nht-cyb/balancing-cube-pendulum/Reports/Slide_Nhom8_Final.pdf

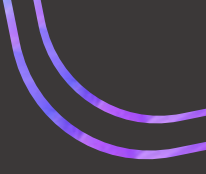
[picture p134: figure]
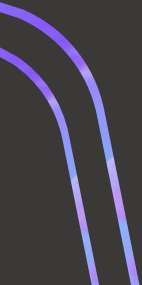
[picture p135: figure]
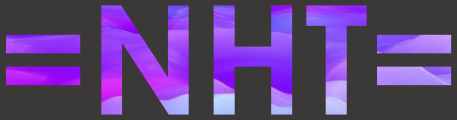
[picture p136: figure]
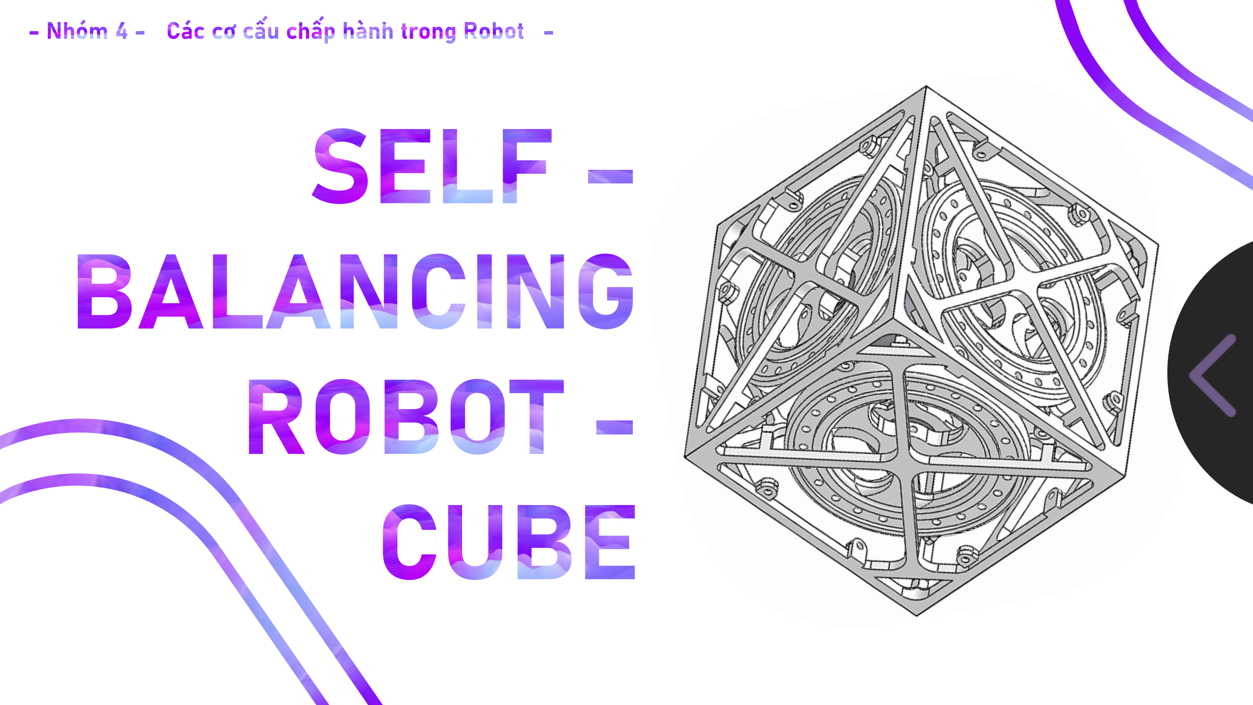
[picture p137: page 3]
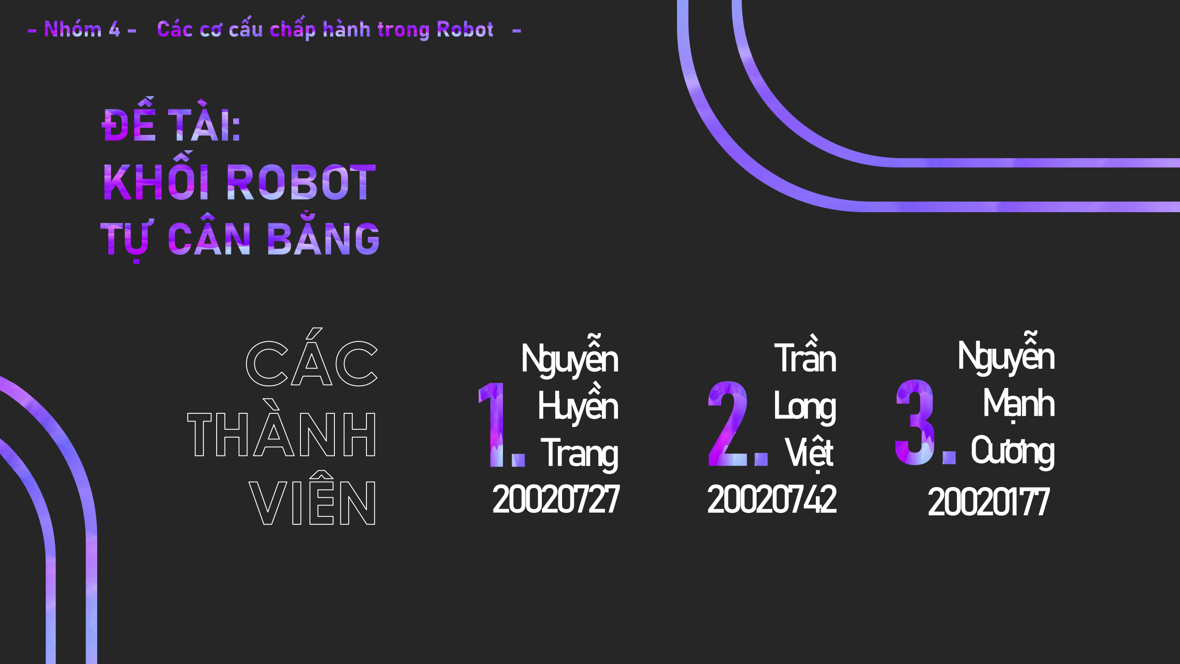
[picture p138: page 4]

## Nguyễn Huyền Trang

20020727

## Trần Long Việt

20020742

## Nguyễn Mạnh Cương

20020177

# ROBOT KHỐI

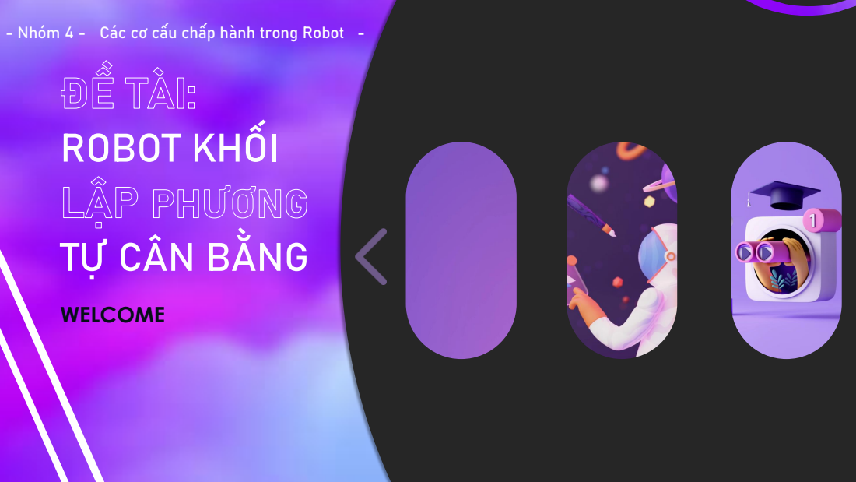
[picture p139: page 5]
WELCOME

- Nhóm 4 - Các cơ cấu chấp hành trong Robot -

TỰ CÂN BẰNG

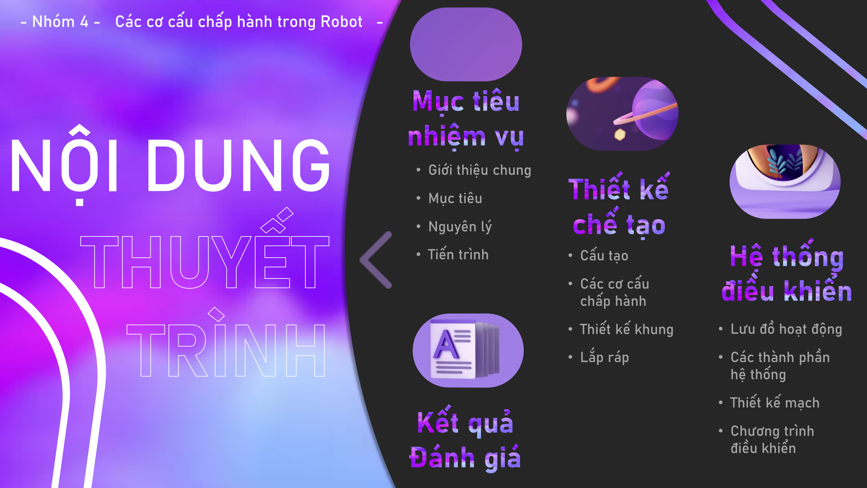
[picture p140: page 6]

# NỘI DUNG

- Nhóm 4 - Các cơ cấu chấp hành trong Robot -
- Giới thiệu chung
- Mục tiêu
- Nguyên lý
- Tiến trình
- Lưu đồ hoạt động
- Các thành phần
hệ thống
- Thiết kế mạch
- Chương trình
điều khiển
- Cấu tạo
- Các cơ cấu
chấp hành
- Thiết kế khung
- Lắp ráp

# MỤC TIÊU

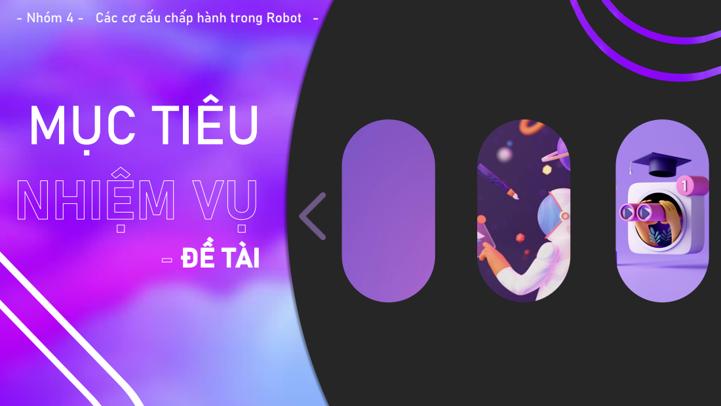
[picture p141: page 7]

- Nhóm 4 - Các cơ cấu chấp hành trong Robot -

# GIỚI

## - Lấy ý tưởng từ Cubli - được tạo ra lần đầu tiên

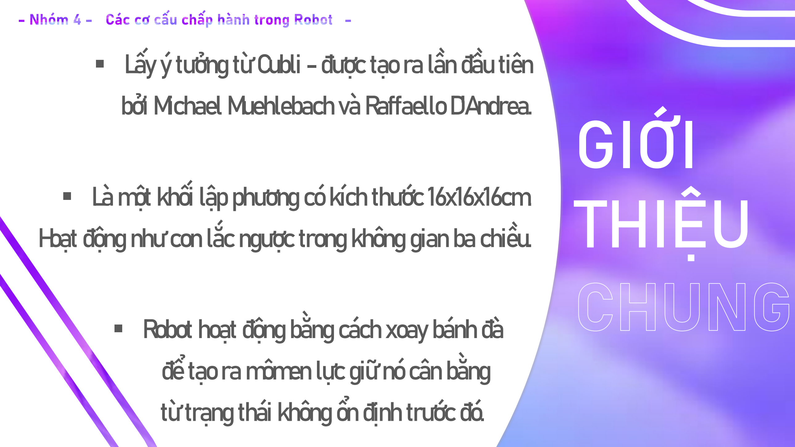
[picture p142: page 8]

# THIỆU

bởi Michael Muehlebach và Raffaello D’Andrea.

- Là một khối lập phương có kích thước 16x16x16cm. Hoạt động như con lắc ngược trong không gian ba chiều.

## - Robot hoạt động bằng cách xoay bánh đà để tạo ra mômen lực giữ nó cân bằng

từ trạng thái không ổn định trước đó.

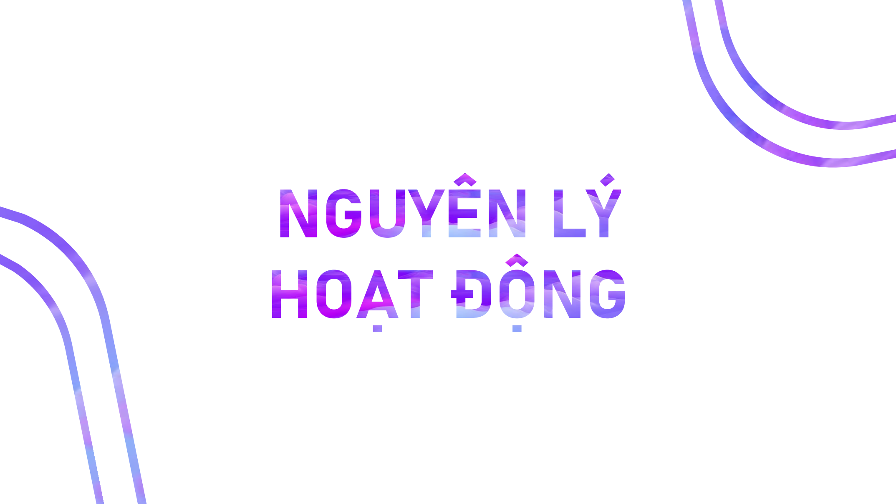
[picture p143: page 9]

## - Dựa trên tác dụng của lực quán tính và nguyên lý

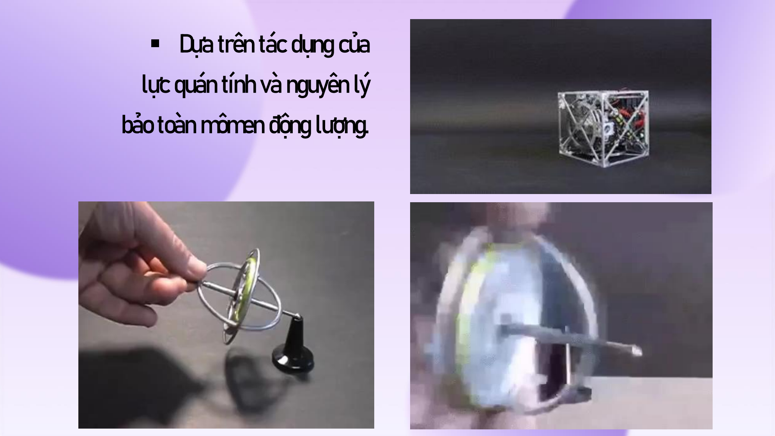
[picture p144: page 10]

bảo toàn mômen động lượng.

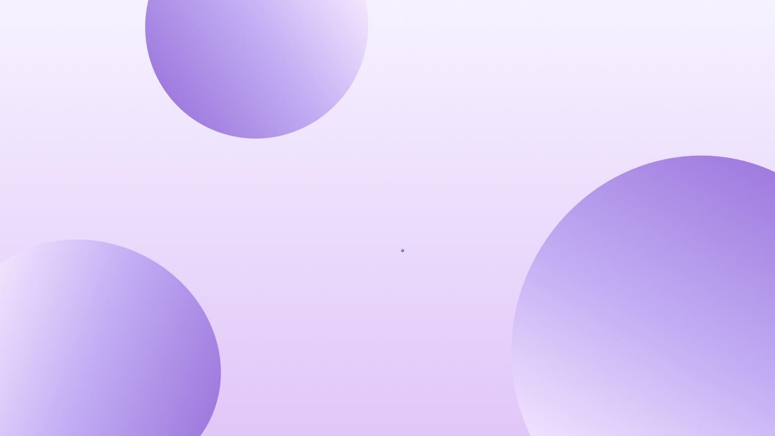
[picture p145: page 11]

# 2. Run

# 1. Records

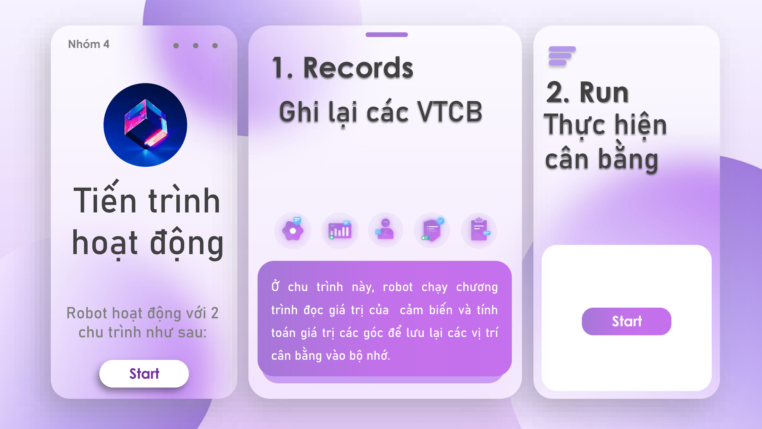
[picture p146: page 12]

Ở chu trình này, robot chạy chương

trình đọc giá trị của cảm biến và

tính toán giá trị các góc để lưu lại các vị trí cân bằng vào bộ nhớ.

# Tiến trình hoạt động

Start

Robot hoạt động với 2
chu trình như sau:
Nhóm 4 | . . .

Start

# Ghi lại các VTCB Thực hiện cân bằng

Ở chu trình này, robot chạy chương

trình đọc giá trị của cảm biến và tính

toán giá trị các góc để lưu lại các vị trí cân bằng vào bộ nhớ.

1.

# Records

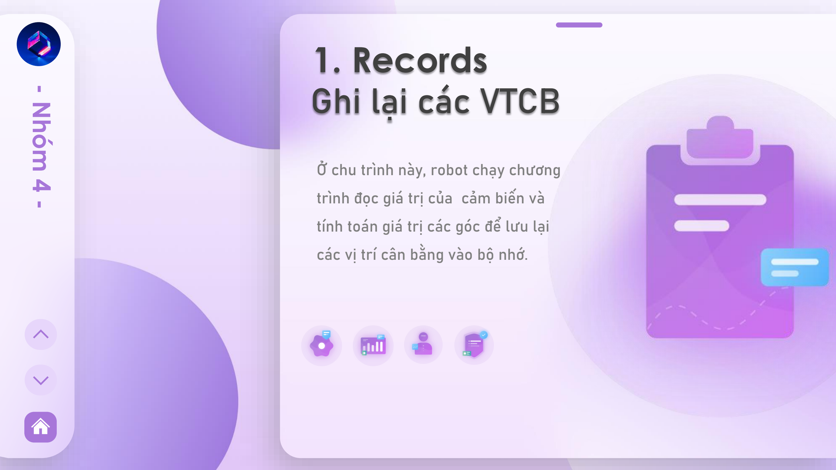
[picture p147: page 13]

Ở chu trình này, robot chạy chương

trình đọc giá trị của cảm biến và

tính toán giá trị các góc để lưu lại các vị trí cân bằng vào bộ nhớ.

# Ghi lại các VTCB

## - Nhóm 4 -

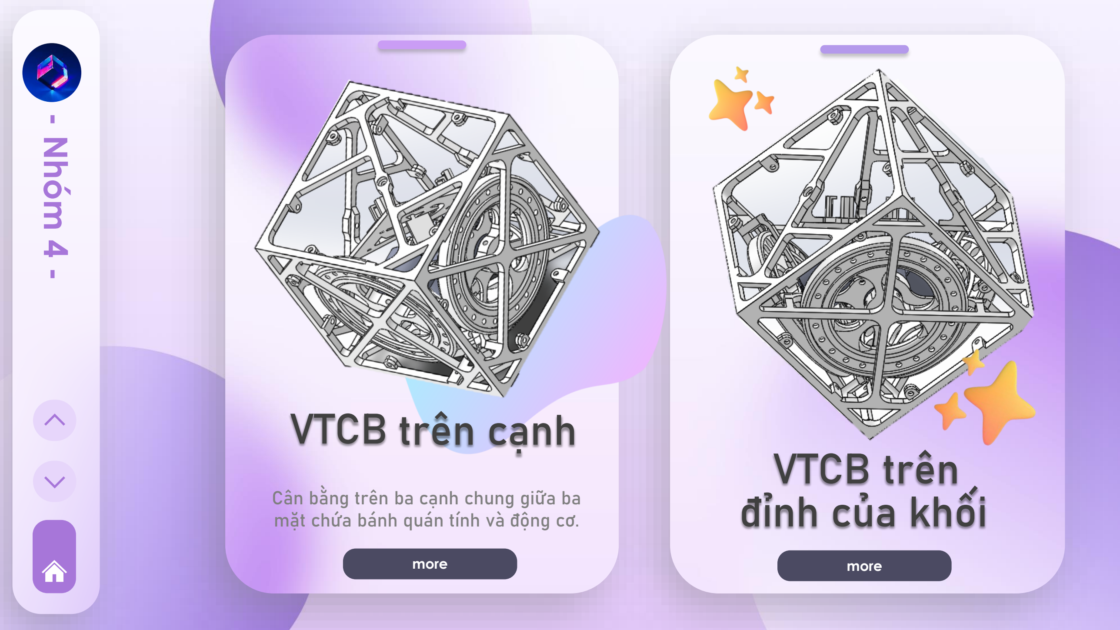
[picture p148: page 14]

# VTCB trên

đỉnh của khối Cân bằng trên ba cạnh chung giữa ba mặt chứa bánh quán tính và động cơ.

more

# VTCB

more

## - Nhóm 4

# trên cạnh

# 2. Run

# Thực hiện

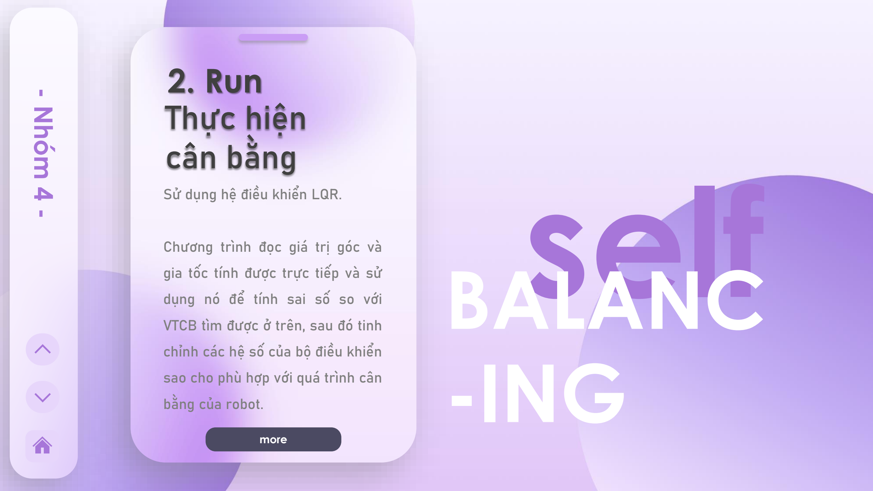
[picture p149: page 15]

more

# self BALANC -ING

## - Nhóm 4 -

# cân bằng

Sử dụng hệ điều khiển LQR

Chương trình đọc giá trị góc và gia tốc tính được trực tiếp và sử

dụng nó để tính sai số so với

VTCB tìm được

ở trên, sau đó tinh
chỉnh các hệ số của bộ điều khiển

sao cho phù hợp với quá trình cân bằng của robot

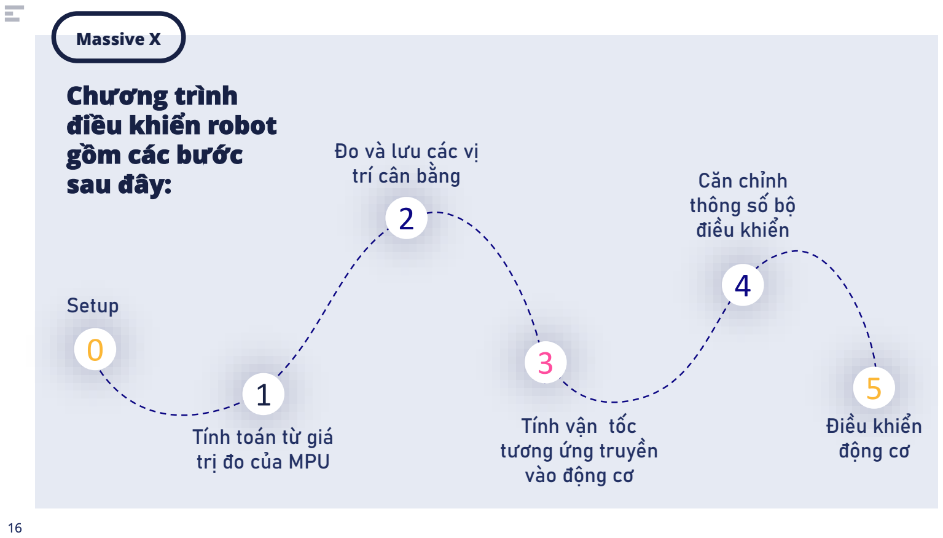
[picture p150: page 16]

16

Massive X

0

Setup

Đo và lưu các vị
trí cân bằng
2

Tính toán từ giá
trị đo của MPU

1
Tính vận tốc
tương ứng truyền
vào động cơ

### Chương trình

### điều khiển robot

### gồm các bước sau đây:

3

4

Căn chỉnh
thông số bộ
điều khiển

5

Điều khiển
động cơ

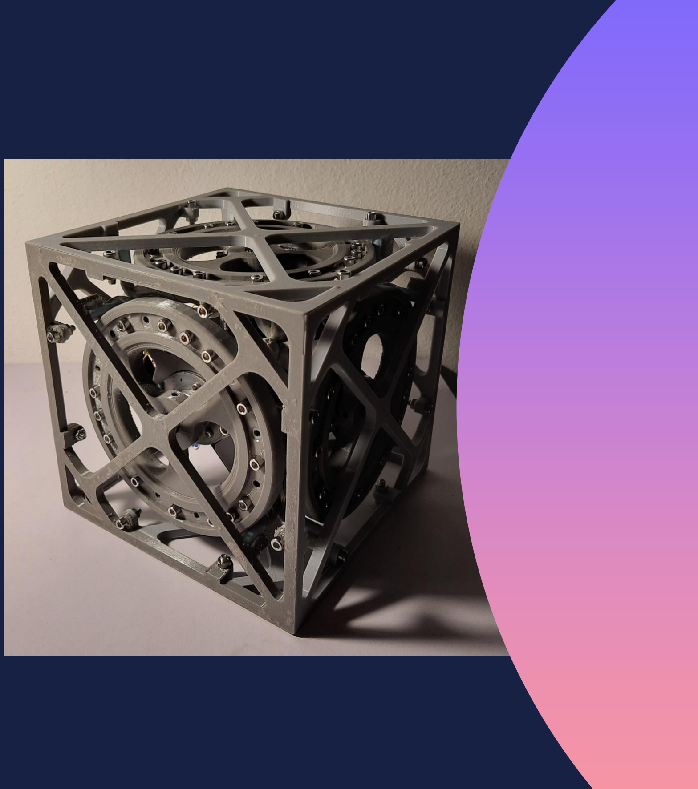
[picture p151: figure]

Massive X presentation to DesignBall team

Massive X

bCc (https://www.facebook.com/)

### Khung robot

01

Được in 3D, chất liệu nhựa PLA

### Mạch điều khiển

02

Sử dụng bộ điều khiển ESP32

### Cơ cấu chấp hành

03

Gồm Cảm biển gia tốc MPU6050 và dộng cơ BLDC Nidec

# Cấu tạo robot

Donec eget viverra nisi, non luctus arcu. Sed ipsum leo, volutpat id convallis vitae, mollis ac dui. Cum sociis natoque penatibus et magnis dis parturient montes, nascetur ridiculus mus. Nulla luctus dapibus metus nec mollis. Etiam lacus nulla, bibendum egestas suscipit ut, sollicitudin eu massa. Phasellus semper quam justo, vel aliquam magna lobortis at.

# Cấu tạo

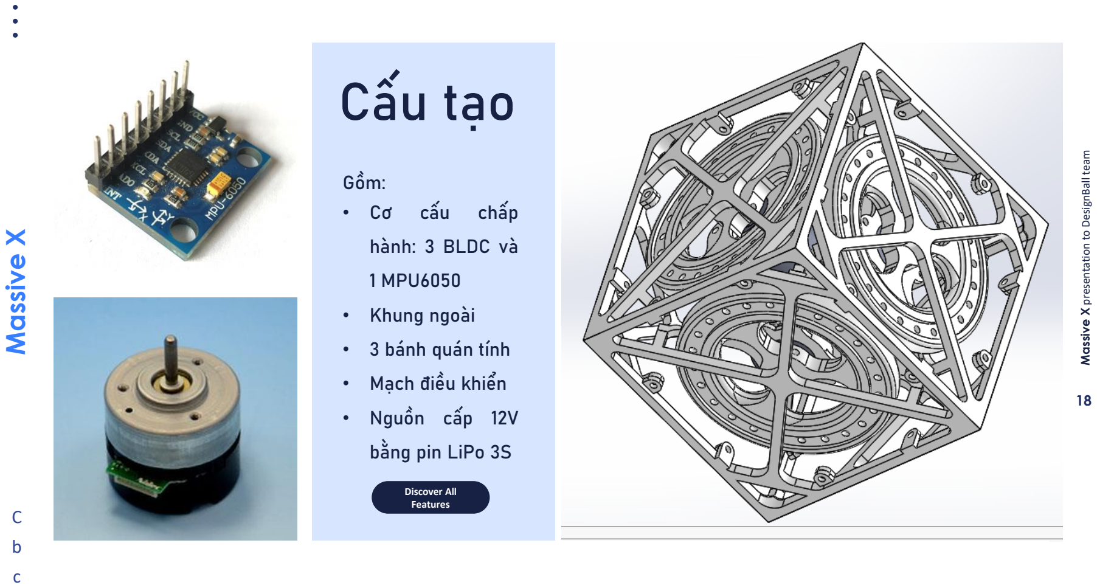
[picture p152: page 18]

Massive X presentation to DesignBall team

Massive X

18

bCc (https://www.facebook.com/)

Gồm: • Cơ | cấu | chấp

hành
:

3 BLDC và

1 MPU6050

- Khung ngoài • 3 bánh quán tính • Mạch điều khiển • Nguồn cấp 12V

bằng pin LiPo
3

S

Discover All
Features

# Khung robot

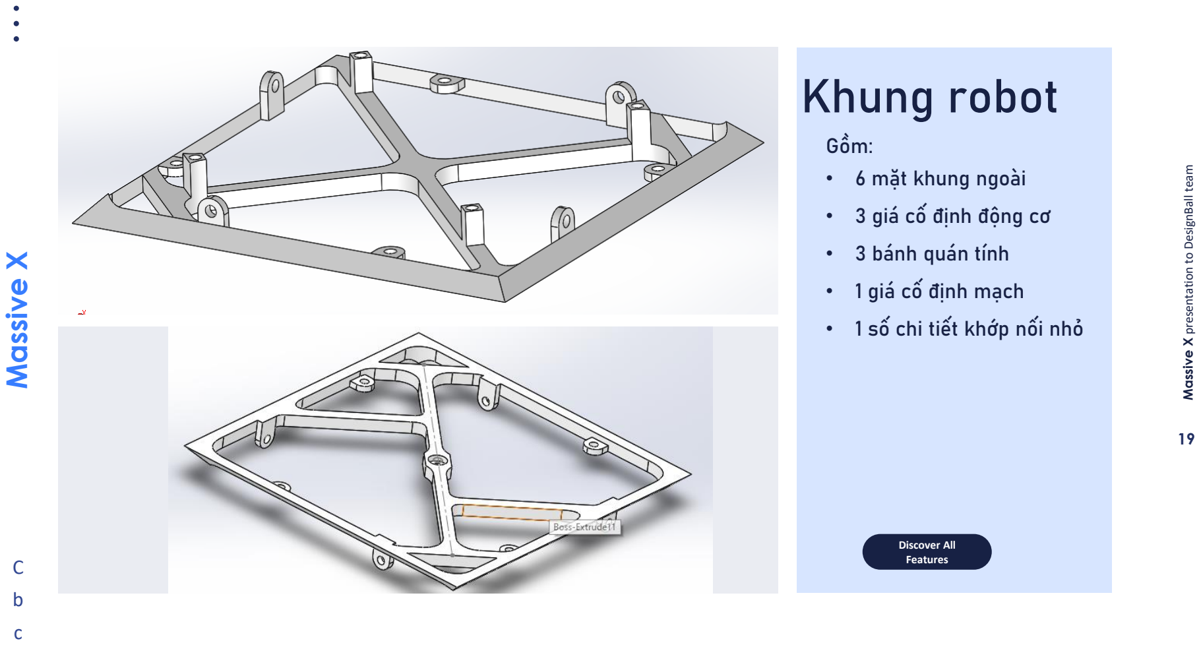
[picture p153: page 19]

Massive X presentation to DesignBall team

Massive X

19

bCc (https://www.facebook.com/)

Discover All
Features

Gồm: • 6 mặt khung ngoài • 3 giá cố định động cơ • 3 bánh quán tính • 1 giá cố định mạch • 1 số chi tiết khớp nối nhỏ

# Khung robot

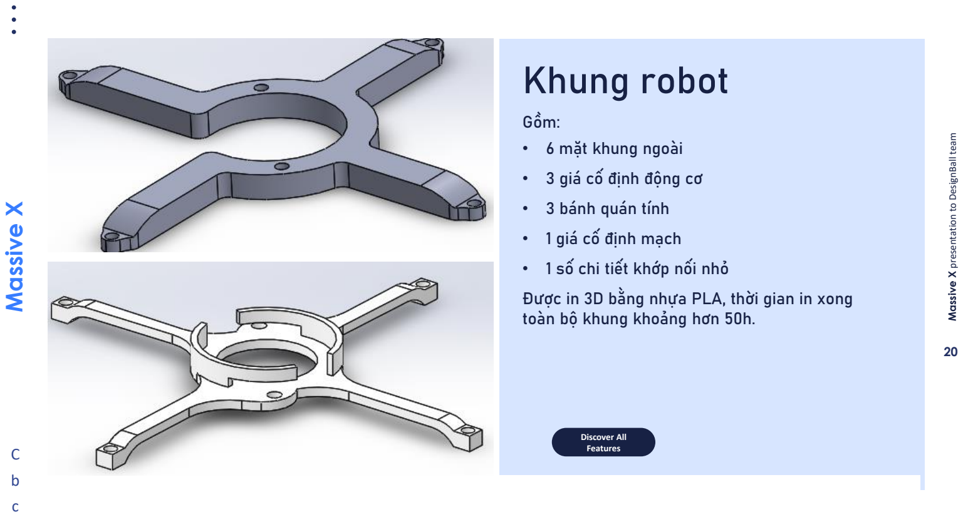
[picture p154: page 20]

Massive X presentation to DesignBall team

Massive X

20

bCc (https://www.facebook.com/)

Gồm: • 6 mặt khung ngoài • 3 giá cố định động cơ • 3 bánh quán tính • 1 giá cố định mạch • 1 số chi tiết khớp nối nhỏ

Discover All
Features

Được in 3D bằng nhựa PLA, thời gian in xong toàn bộ khung khoảng hơn 50h.

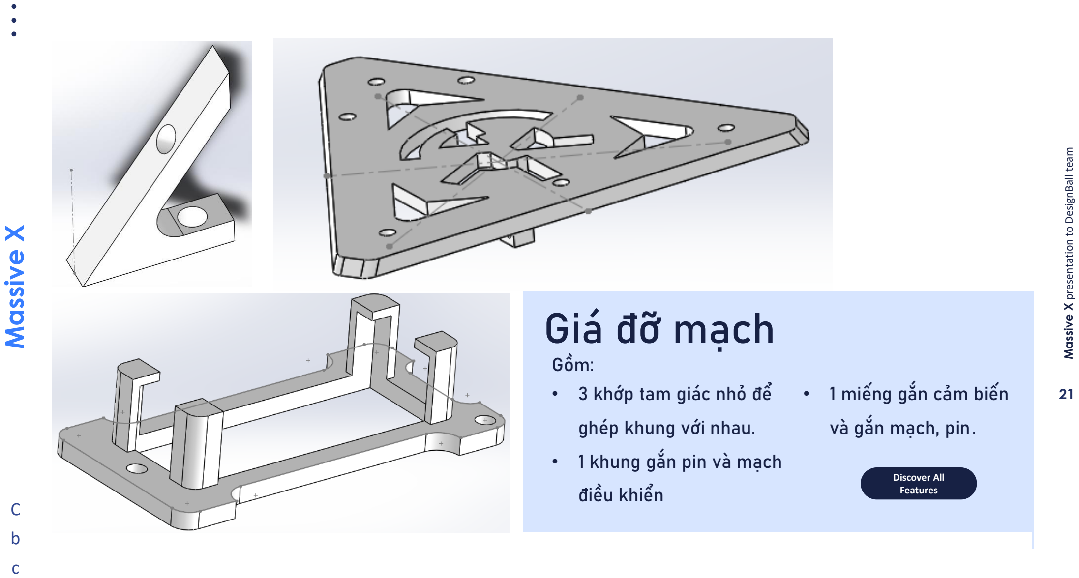
[picture p155: page 21]

Massive X presentation to DesignBall team

Massive X

21

bCc (https://www.facebook.com/)

Gồm: • 3 khớp tam giác nhỏ để

ghép khung với nhau.
- 1 khung gắn pin và mạch

điều khiển

Discover All
Features

# Giá đỡ mạch

- 1 miếng gắn cảm biến

và gắn mạch, pin

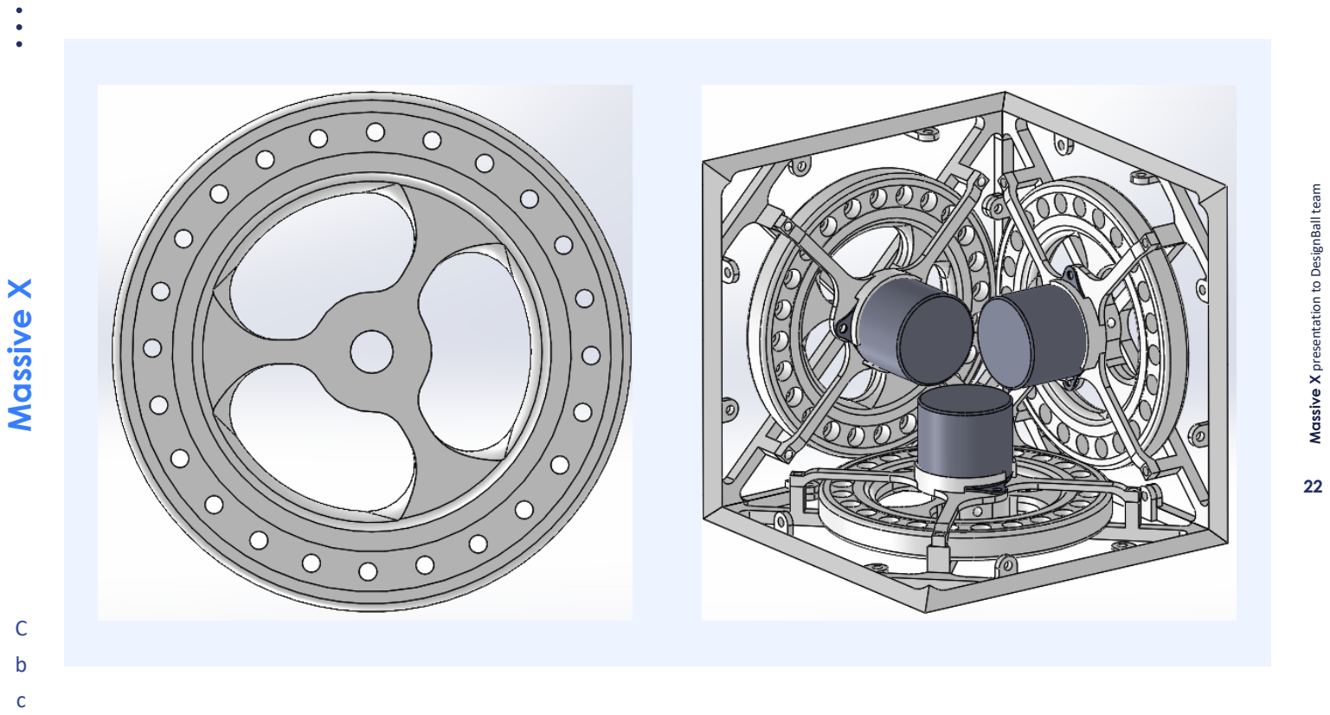
[picture p156: page 22]

Massive X presentation to DesignBall team

Massive X

22

bCc (https://www.facebook.com/)

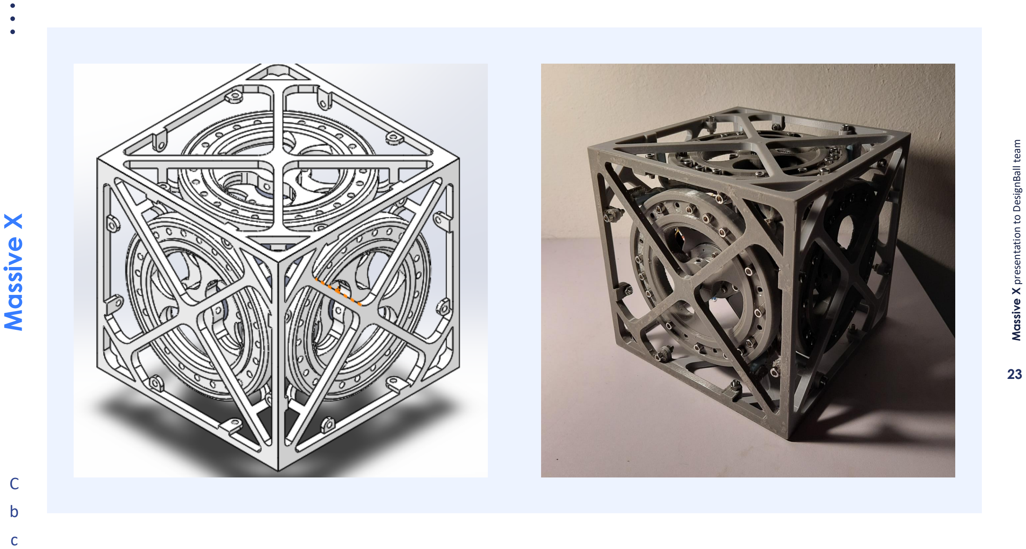
[picture p157: page 23]

Massive X presentation to DesignBall team

Massive X

23

bCc (https://www.facebook.com/)

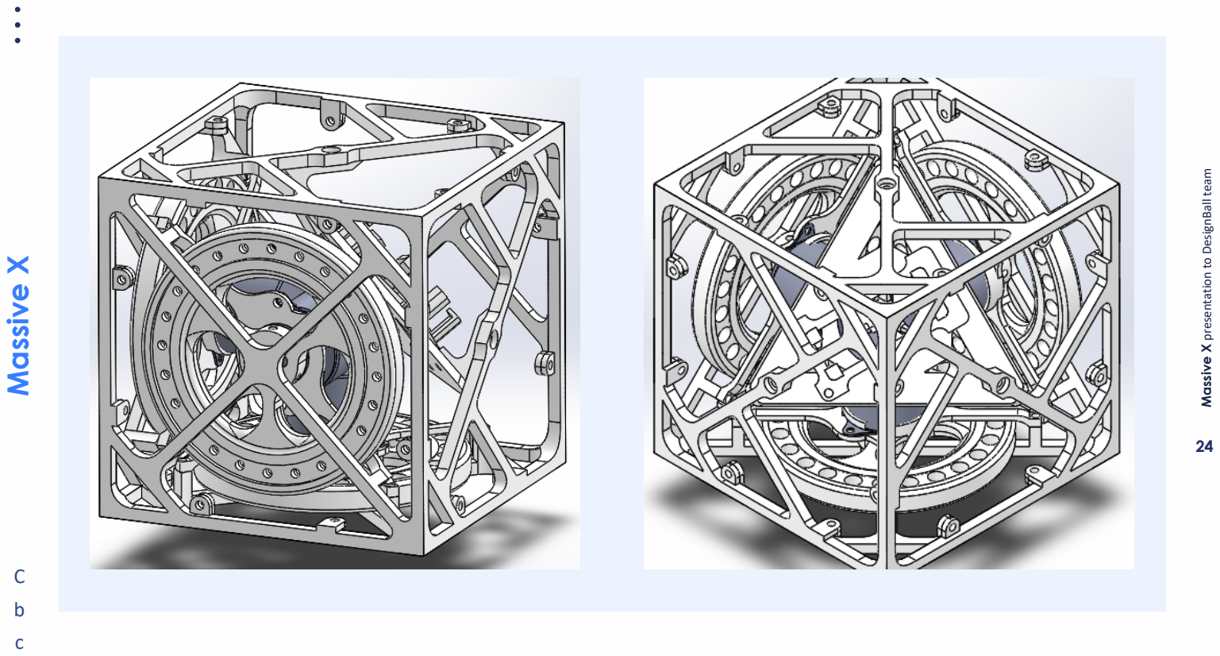
[picture p158: page 24]

Massive X presentation to DesignBall team

Massive X

24

bCc (https://www.facebook.com/)

Massive X presentation to DesignBall team

Massive X

25

b (https://www.facebook.com/)

C (https://www.linkedin.com/)

c (https://twitter.com/)

# Các vấn đề nảy sinh

- Kích thước vẽ và kích thước in có sự chênh lệch. Quá trình thiết kế phần cứng khi vẽ

3D trên Solidworks còn chưa có kinh nghiệm và chưa được kiểm tra kỹ lưỡng dẫn

đến một số kích thước sai. Các mối nối không khớp, không lắp vào nhau được.

- Bánh chạm vào nhau khi quay; trục bánh bé, không vừa trục động cơ.
- Trục giữ động cơ yếu, không thể chịu được khối lượng động cơ và bánh; chiều cao của

trục quá lớn nên khi ghép các mặt bị chạm nhau.

- Quá trình hàn mạch còn hàn sai, hỏng bảng mạch, phải hàn lại nhiều lần.
- Giải quyết: đo, cắt gọt, mài thủ công để các chi tiết vừa khớp.

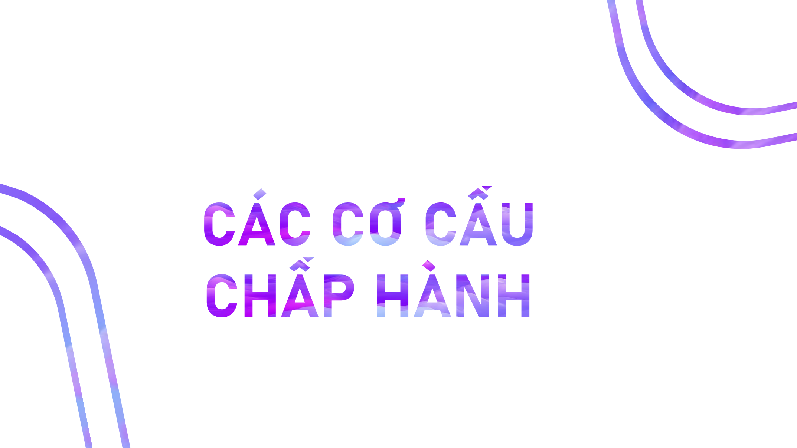
[picture p159: page 26]

Massive X presentation to DesignBall team

Massive X

26

bCc (https://www.facebook.com/)

# Động cơ BLDC Nidec 24H

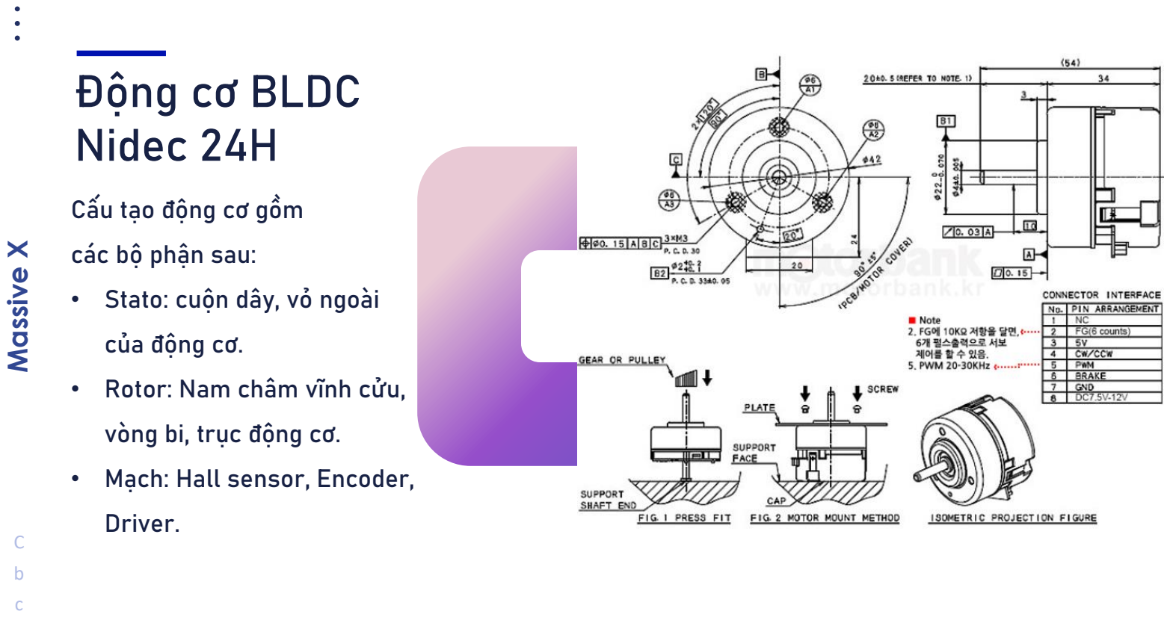
[picture p160: page 27]

Massive X presentation to DesignBall team

Massive X

27

bCc (https://www.facebook.com/)

Cấu tạo động cơ gồm

các bộ phận sau: • Stato: cuộn dây, vỏ ngoài

của động cơ.

- Rotor: Nam châm vĩnh cửu,

vòng bi, trục động cơ.

- Mạch: Hall sensor, Encoder,

Driver.

Massive X presentation to DesignBall team

Massive X

28

b (https://www.facebook.com/)

C (https://www.linkedin.com/)

c (https://twitter.com/)

# Động cơ BLDC

- Stator: được cấu tạo từ các lá thép kỹ thuật điện với các cuộn dây được đặt trong các khe cắt xung quanh chu vi phía trong của stator.
- Rotor được cấu tạo gồm nam châm vĩnh cửu, có nhiệm vụ kích từ. Rotor: được gắn

vào trục động cơ và trên bề mặt rotor có dán các thanh nam châm vĩnh cửu.
- Rotor được gắn với trục xoay của động cơ, trục chính phía trước gắn với tải, trục phụ

phía sau gắn với cảm biến Hall và encoder quang học.

- Khi dòng điện chạy qua một trong ba cuộn dây stator sẽ tạo ra cực từ hút những nam châm vĩnh cửu gần nhất có cực từ trái dấu. Cấp điện tuần tự cho mỗi cuộn dây sẽ làm

cho rotor quay theo từ trường quay. Rotor sẽ tiếp tục chuyển động nếu dòng điện dịch

chuyển sang một cuộn dây liền kề.

Massive X presentation to DesignBall team

Massive X

29

bCc (https://www.facebook.com/)

Giá trị | Điều kiện hoạt động | Min.

Thông

thường

Max. Đơn vị

Điện thế hoạt động

Loại động cơ 12

V | 8.0 | 12 | 15

V

Loại động cơ 24

V | 21.6 | 24 | 26.4

V

Dòng điện hoạt động | Vận hành liên tục
- | 0.75 | 0.9

A
Lực xoay mômen xoắn | Vận hành liên tục
- | 20 | 50 | mN.m
Output power | Vận hành liên tục

5

7 | 9.0

W

Tốc độ không tải

3500 | 4300 | 4900
rpm
- 5900

Quán tính của rotor | Giá trị được tính toán
- 14.0
Hằng số cơ học | Giá trị được tính toán
- 2.1
- msec
Hằng số điện | Giá trị được tính toán
- 1.2
- msec

Áp suất âm

Không tải, đến
, đo cách động cơ

30cm

- | 50 | dB(A)

Nhiệt độ làm việc

Độ ẩm từ
5

% đến 90
%

, không bão

hòa

10

- 50
Khối lượng động cơ | Không
- 110

g
Tuổi thọ | 5000

h

Massive X presentation to DesignBall team

Massive X

30

b (https://www.facebook.com/)

C (https://www.linkedin.com/)

c (https://twitter.com/)

STT | Tên gọi | Chức năng
1 | CHA | Dùng encoder: Kênh A đầu ra của encoder; kiểm tra pha, xung trên một vòng quay;
| | điện áp: HIGH = 5V, LOW = 0V.
2 | CHB | Dùng encoder: Kênh B đầu ra của encoder; kiểm tra pha , 100 xung trên một vòng
| | quay; điện áp: HIGH = 5V, LOW = 0V.
| FG | Chế độ cơ bản: open-drain tachometer: thiết bị đo tốc độ góc cấu hình chân open-
| | drain, khi sử dụng cần nối thêm trở ngoài vào mạch, đo 6 xung trên 1 vòng xoay, .
3 | Vin | Cổng logic. Cấp nguồn từ 3.3V – 5.5V cho encoder
4 | DIR | Dây tín hiệu đảo chiều xoay của động cơ. đến , hoặc cổng tín hiệu mở OPEN thì động
| | cơ xoay theo chiều kin đồng hồ; thì động cơ xoay ngược chiều kim đồng hồ.
5 | PWM | Truyền tín hiệu xung điều khiển tốc độ quay của động cơ.
6 | EN/BRAKE | Dây phanh để nối ngắn nguồn dừng khẩn cấp động cơ.
7 | GND | Dây đất, cấp nguồn điện tích âm cho động cơ.
8 | VCC | Cấp nguồn điện dương cho động cơ, dòng DC .

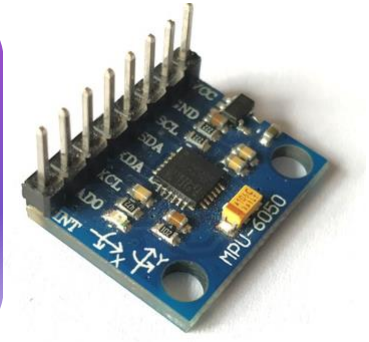
[picture p161: figure]

Massive X presentation to DesignBall team

Massive X

31

bCc (https://www.facebook.com/)

# Cảm biến gia tốc góc MPU6050

MPU6050 là một Hệ thống động cơ điện vi

mô: bao gồm gia tốc kế ba trục và con quay

hồi chuyển ba trục. • Để đo góc và xác định vị trí của robot

trong không gian theo các chiều X, Y, Z.

- Xác định vị trí, vận tốc, gia tốc của robot.

Massive X presentation to DesignBall team

Massive X

32

b (https://www.facebook.com/)

C (https://www.linkedin.com/)

c (https://twitter.com/)

# Cảm biến gia tốc góc MPU6050

- MPU6050 có một gia tốc kế trên chip có thể đo gia tốc trên bốn dải thang đo đầy đủ có

thể lập trình là ±2g, ±4g, ±8g và ±16g.

- MPU6050 có một con quay hồi chuyển trên chip có thể đo góc quay trên bốn phạm vi tỷ lệ

đầy đủ có thể lập trình là ±250°/s, ±500°/s, ±1000°/s và ±2000°/s.

- Bên trong cảm biến tích hợp 6 trục cảm biến bao gồm con quay hồi 3 chuyển trục X, Y, Z.

## Các thành phần hệ thống

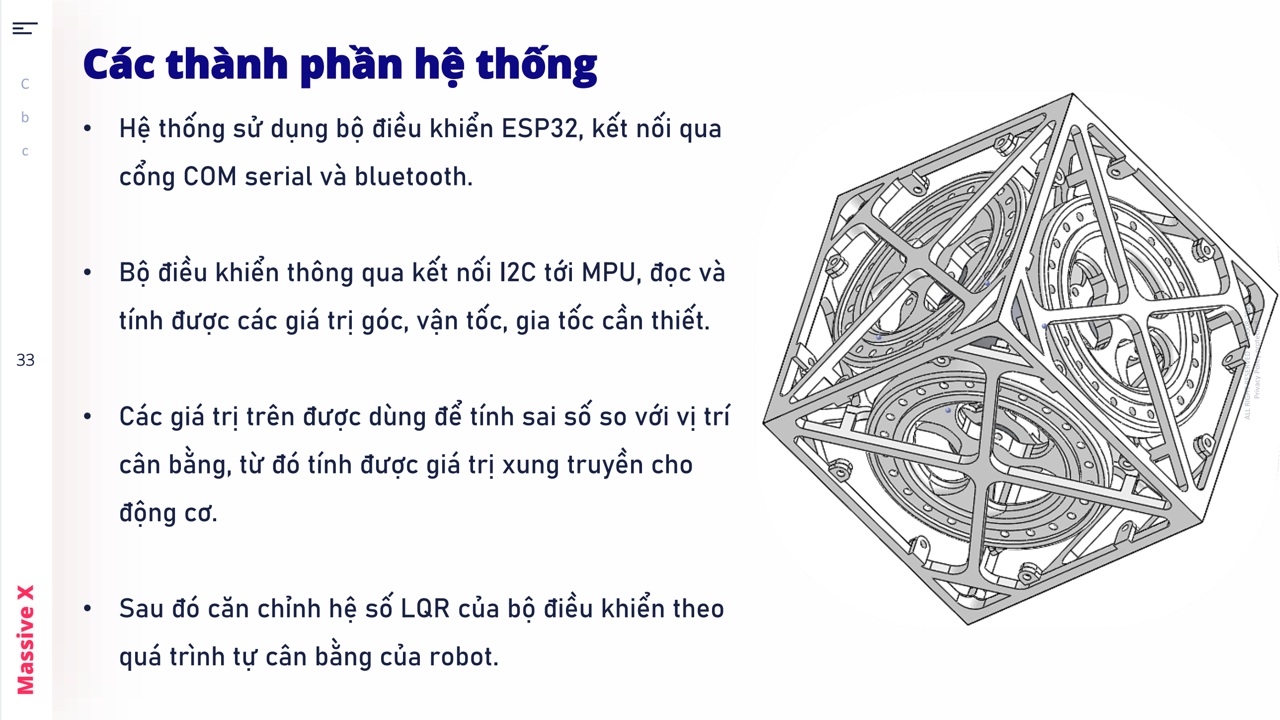
[picture p162: page 33]

Massive X

33

- Hệ thống sử dụng bộ điều khiển ESP32, kết nối qua

cổng COM serial và bluetooth.

- Bộ điều khiển thông qua kết nối I2C tới MPU, đọc và

tính được các giá trị góc, vận tốc, gia tốc cần thiết.

- Các giá trị trên được dùng để tính sai số so với vị trí cân bằng, từ đó tính được giá trị xung truyền cho

động cơ.

- Sau đó căn chỉnh hệ số LQR của bộ điều khiển theo quá trình tự cân bằng của robot.

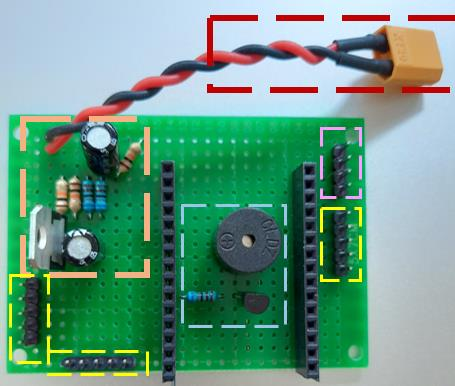
[picture p163: figure]

Massive X presentation to DesignBall team

Massive X

34

b (https://www.facebook.com/)

C (https://www.linkedin.com/)

c (https://twitter.com/)

# Mạch điều khiển gồm:

- 1 khối đỏ cấp nguồn chính 12V cho 3 động cơ.
- 1 khối cam lấy nguồn 12V hạ áp xuống 5V để cấp

cho ESP32 và MPU6050

- 3 khối vàng gồm 5 chân pin cắm 3 động cơ BLDC
- 1 khối hồng gồm 4 chân pin cắm 1 cảm biến

MPU6050

- 1 khối xanh gồm mạch còi chíp và đèn led bảo

hiệu chương trình.

- 2 hàng jump 15 chân cắm mạch điều khiển

ESP32

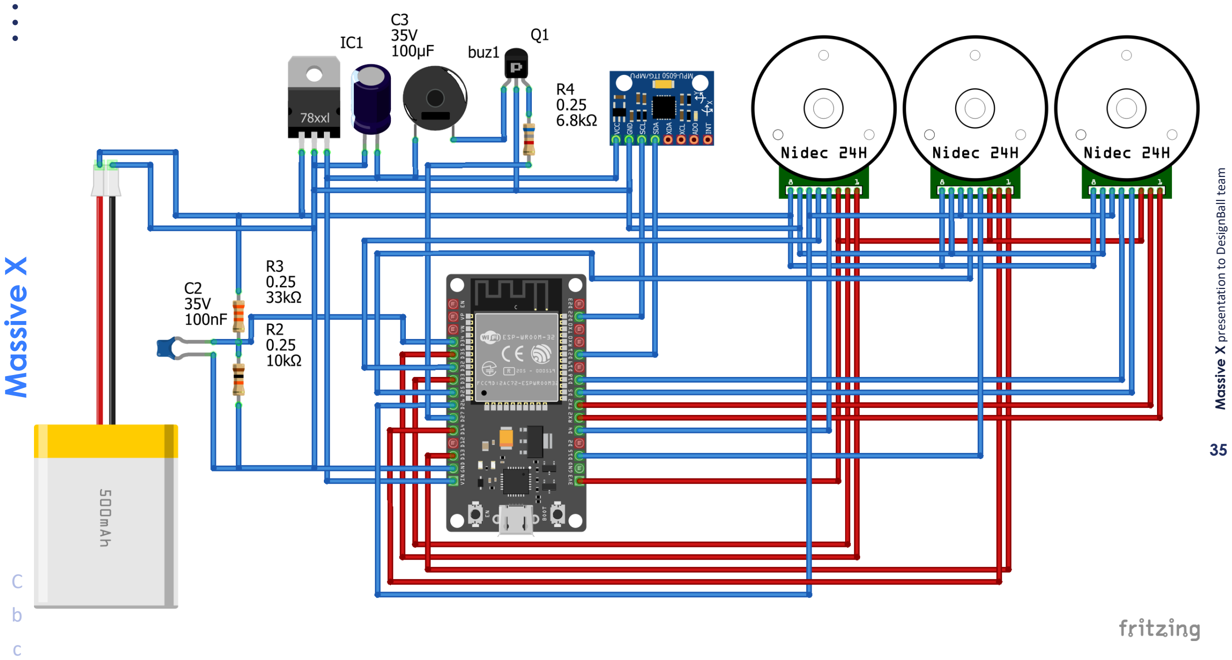
[picture p164: page 35]

Massive X presentation to DesignBall team

Massive X

35

bCc (https://www.facebook.com/)

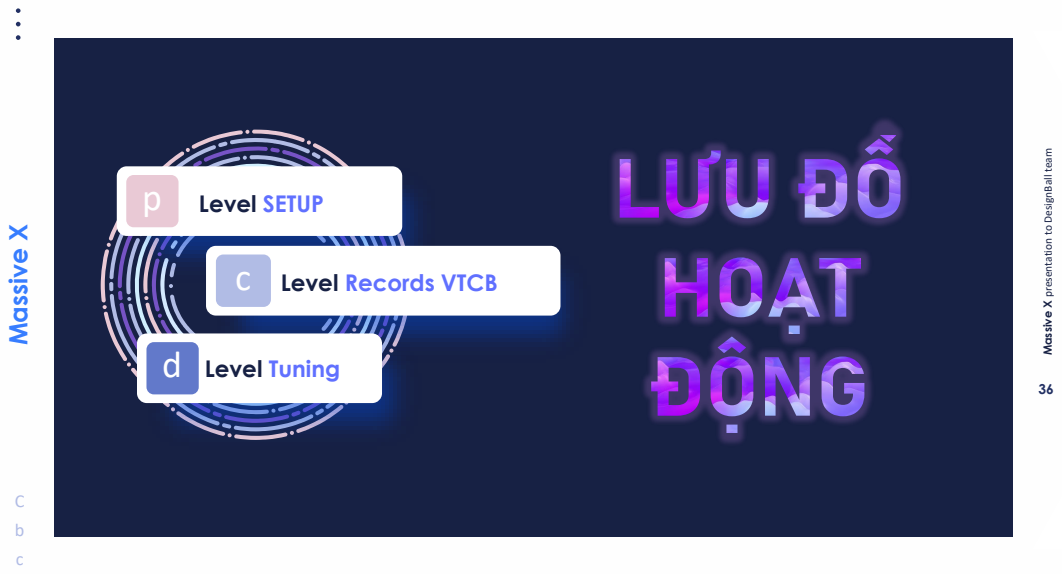
[picture p165: page 36]
Massive X; bCc; Level SETUP; Level Records VTCB; Level Tuning

Massive X presentation to DesignBall team

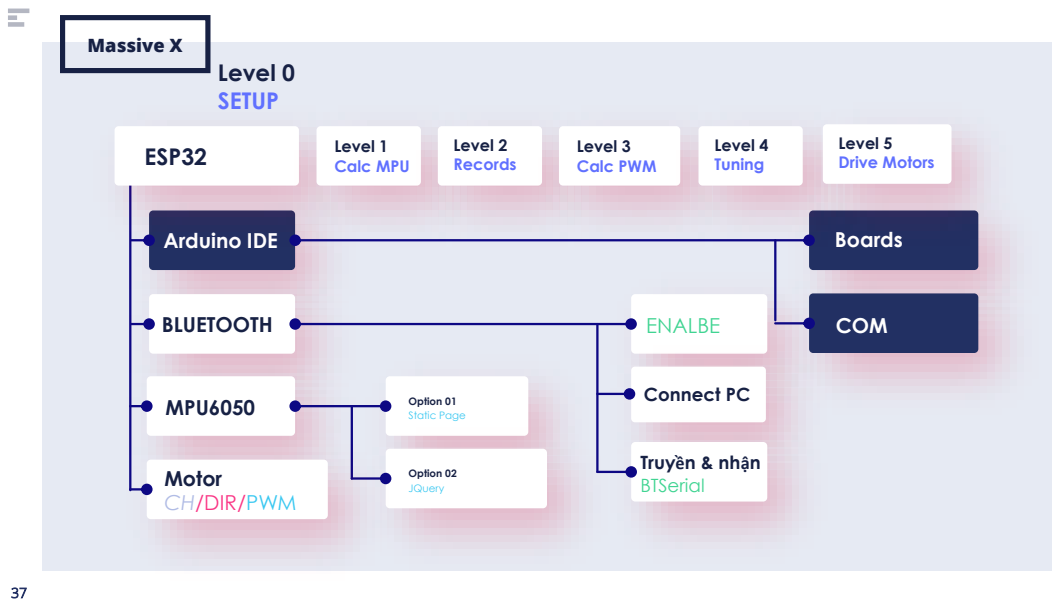
[picture p166: page 37]
Massive X; Option 01; Static Page; Option 02; JQuery; ENALBE; Connect PC; Arduino IDE; Boards; ESP32; BLUETOOTH; MPU6050; Level 0 SETUP; COM; Truyền & nhận BTSerial; Level 1 Calc MPU; Level 2 Records; Level 3 Calc PWM; Level 4 Tuning; Level 5 Drive Motors

Motor
CH/DIR/PWM

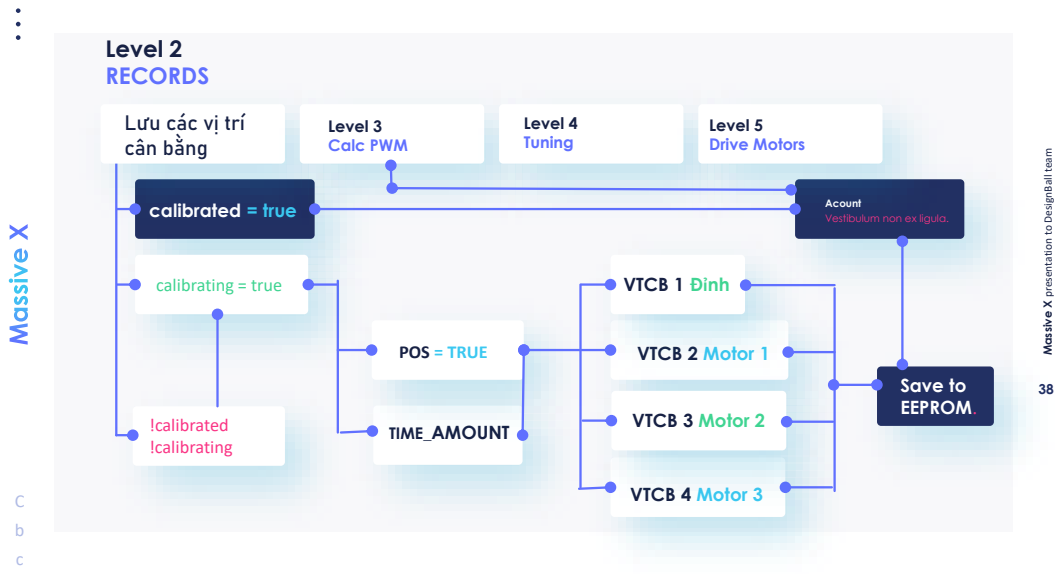
[picture p167: page 38]
VTCB 2 Motor 1; TIME_AMOUNT; VTCB 1 Đỉnh; VTCB 4 Motor 3; Acount calibrated = true; Vestibulum non ex ligula.; calibrating = true; POS = TRUE; Level 2 RECORDS; !calibrated !calibrating; Save to EEPROM.; VTCB 3 Motor 2; Level 3 Calc PWM; Level 4 Tuning; Level 5 Drive Motors

Lưu các vị trí
cân bằng

Massive X presentation to DesignBall team

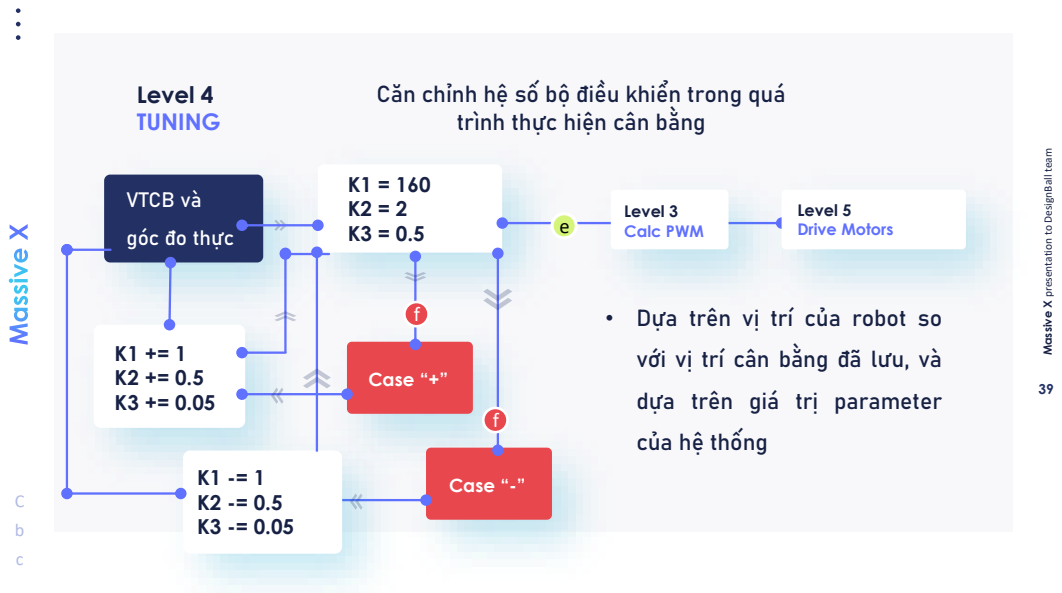
[picture p168: page 39]
bCc; Case “+” f; Level; 4 TUNING; Case “; 3 Calc PWM; 5 Drive Motors

Căn chỉnh hệ số bộ điều khiển trong quá

trình thực hiện cân bằng

Massive X presentation to DesignBall team

VTCB và
góc đo thực

• Dựa trên vị trí của robot so
với vị trí cân bằng đã lưu, và

dựa trên giá trị parameter
của hệ thống

U

s

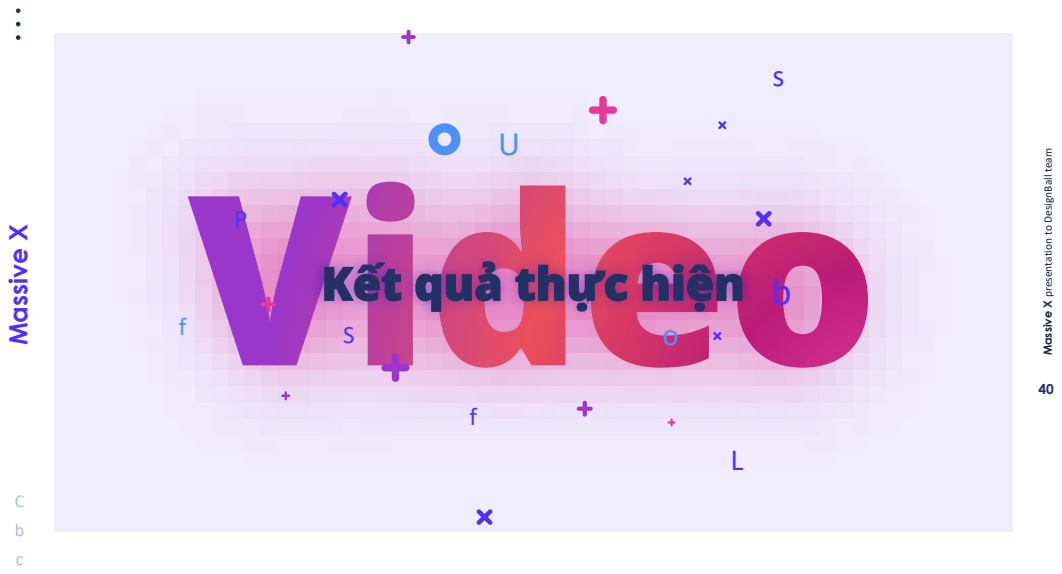
[picture p169: page 40]
Massive X; bCc

Massive X presentation to DesignBall team

Kết quả thực hiện o

U

s

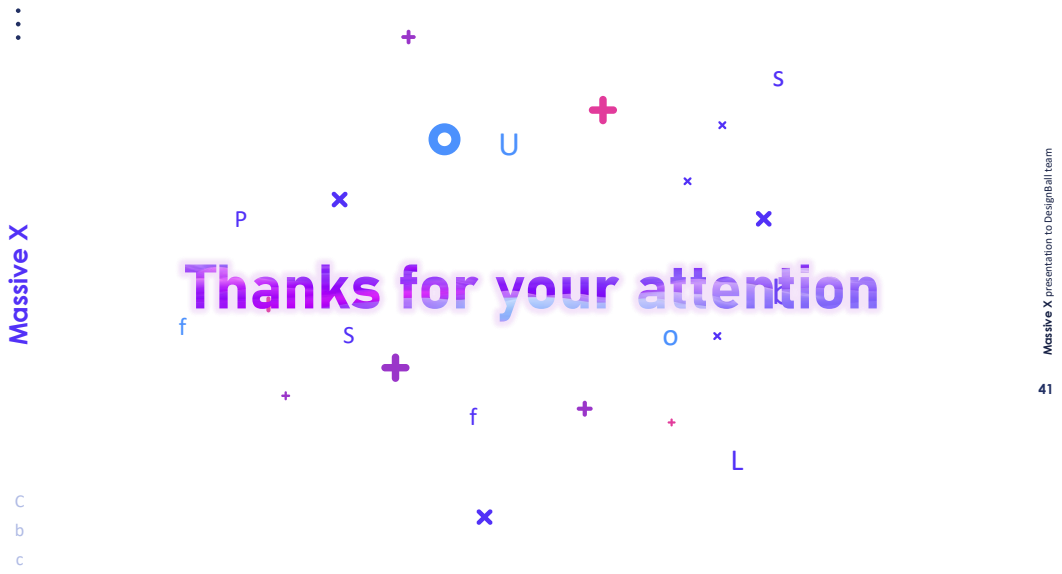
[picture p170: page 41]
Massive X; bCc

Massive X presentation to DesignBall team
