nht-cyb/balancing-cube-pendulum/model/20221113_214621.jpg

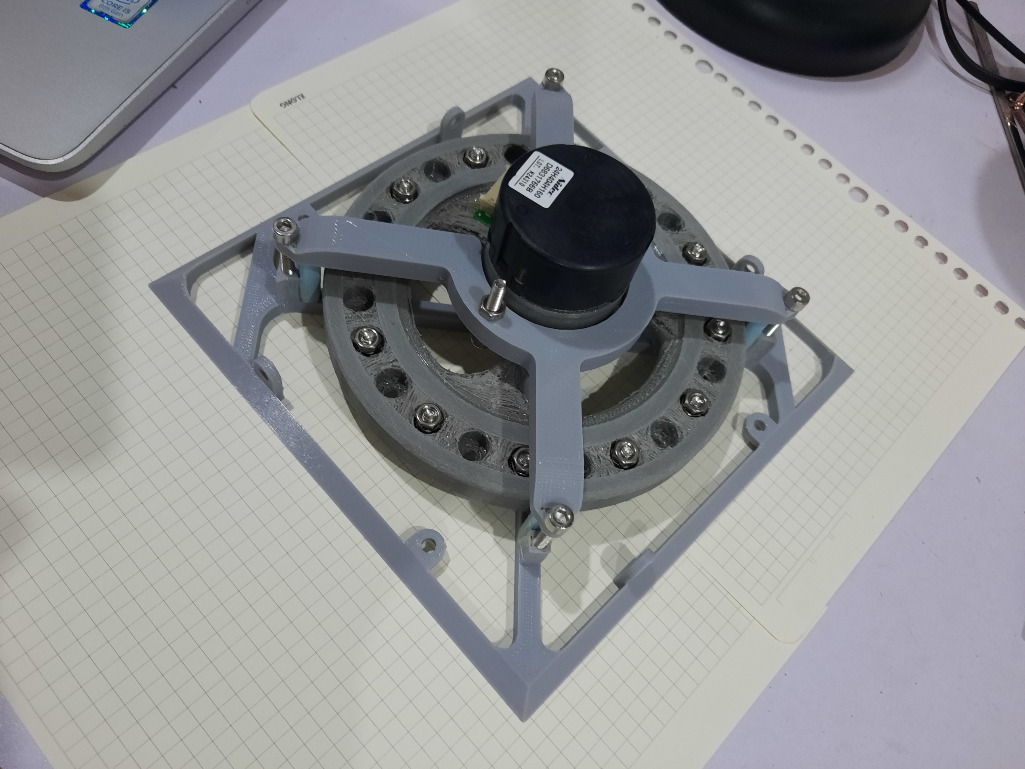
model/20221113_214621.jpg
