nht-cyb/balancing-cube-pendulum/model/20221113_214658.jpg

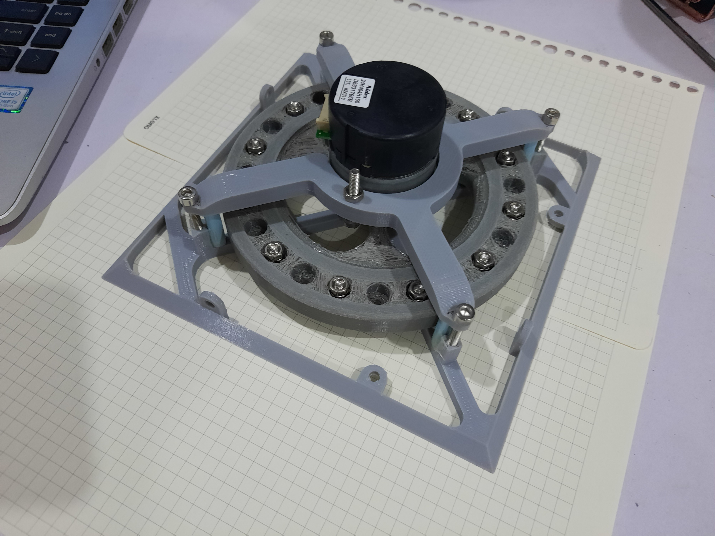
model/20221113_214658.jpg
