nht-cyb/balancing-cube-pendulum/model/20221113_215314.jpg

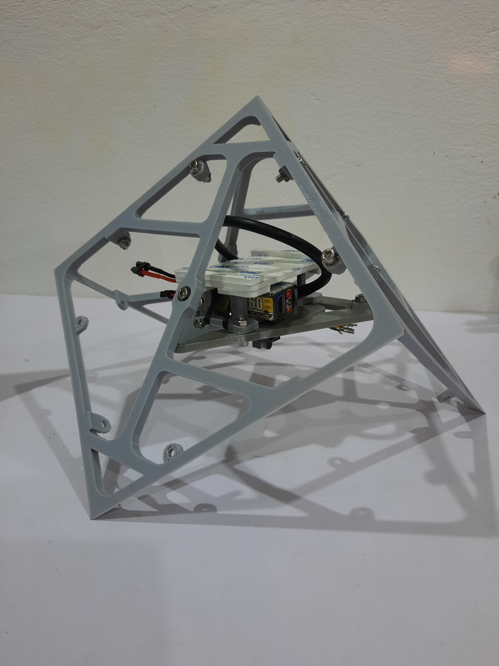
model/20221113_215314.jpg
