nht-cyb/balancing-cube-pendulum/model/20221113_215345.jpg

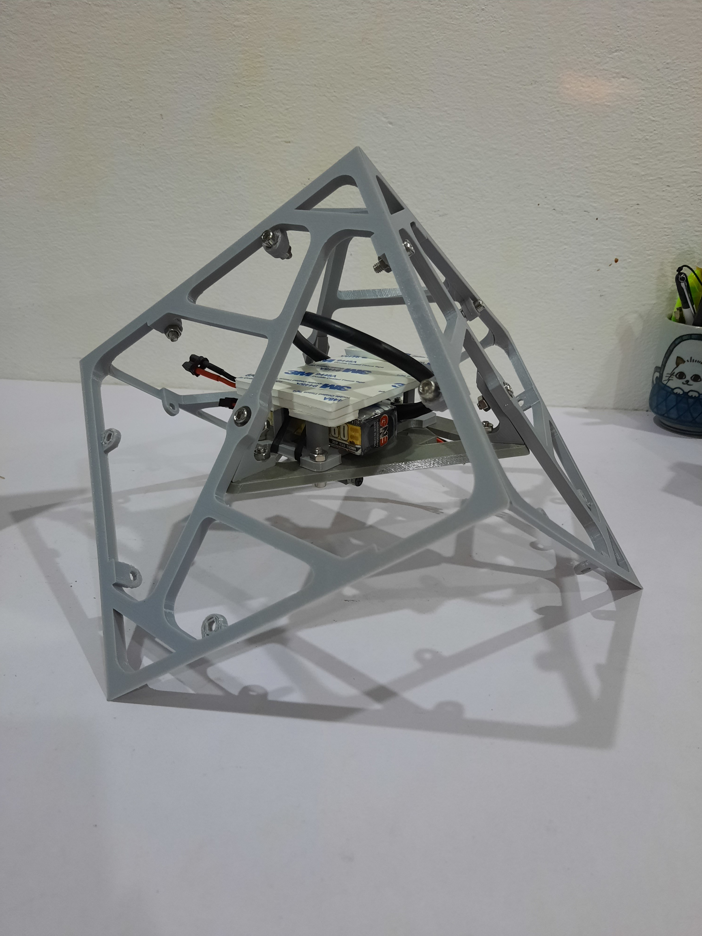
model/20221113_215345.jpg
