nht-cyb/balancing-cube-pendulum/model/20221113_215417.jpg

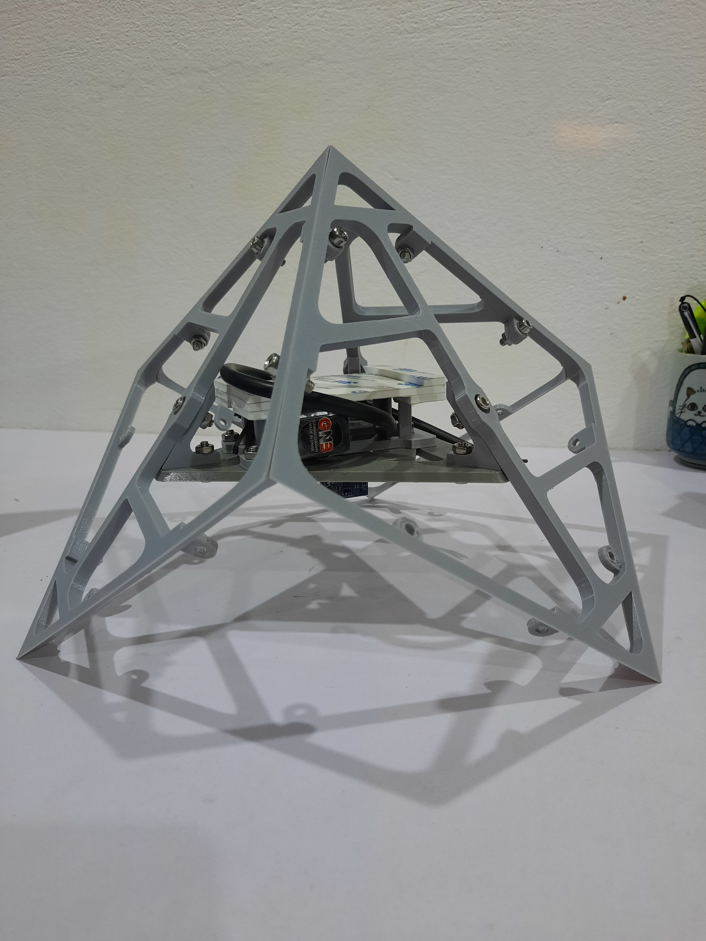
model/20221113_215417.jpg
