nht-cyb/balancing-cube-pendulum/model/20221121_040226.jpg

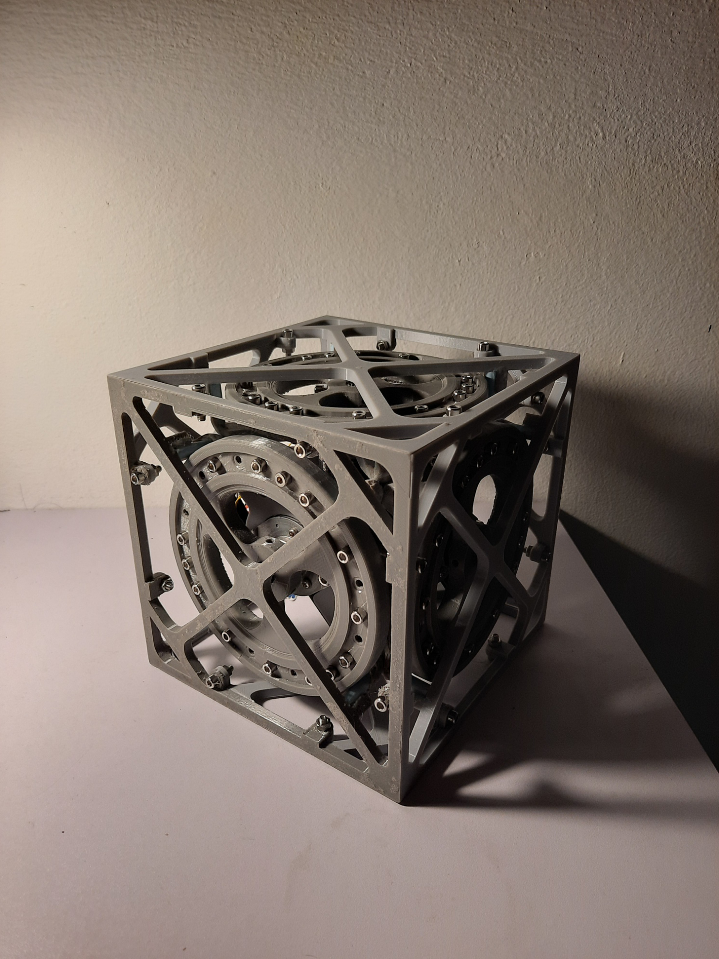
model/20221121_040226.jpg
