nht-cyb/balancing-cube-pendulum/model/20221121_040506.jpg

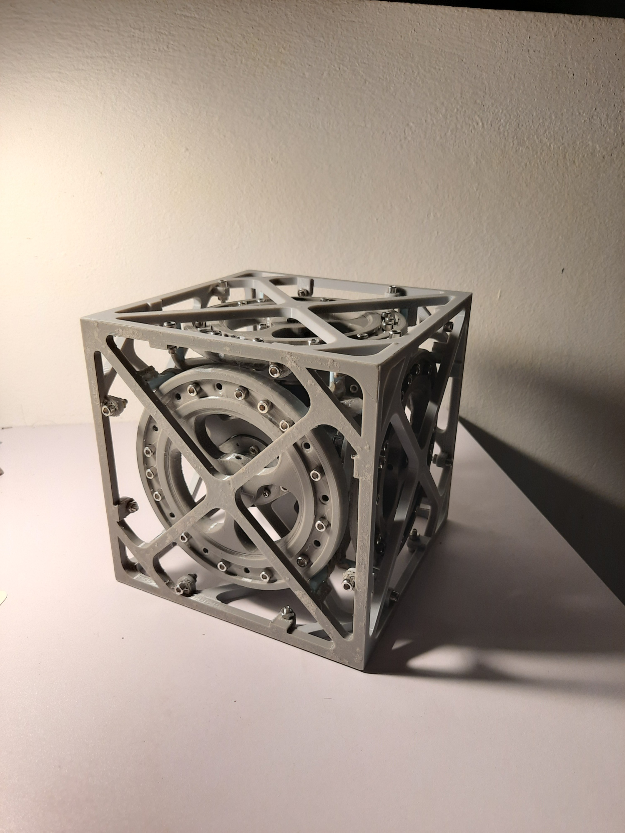
model/20221121_040506.jpg
