nht-cyb/balancing-cube-pendulum/model/20221121_040553.jpg

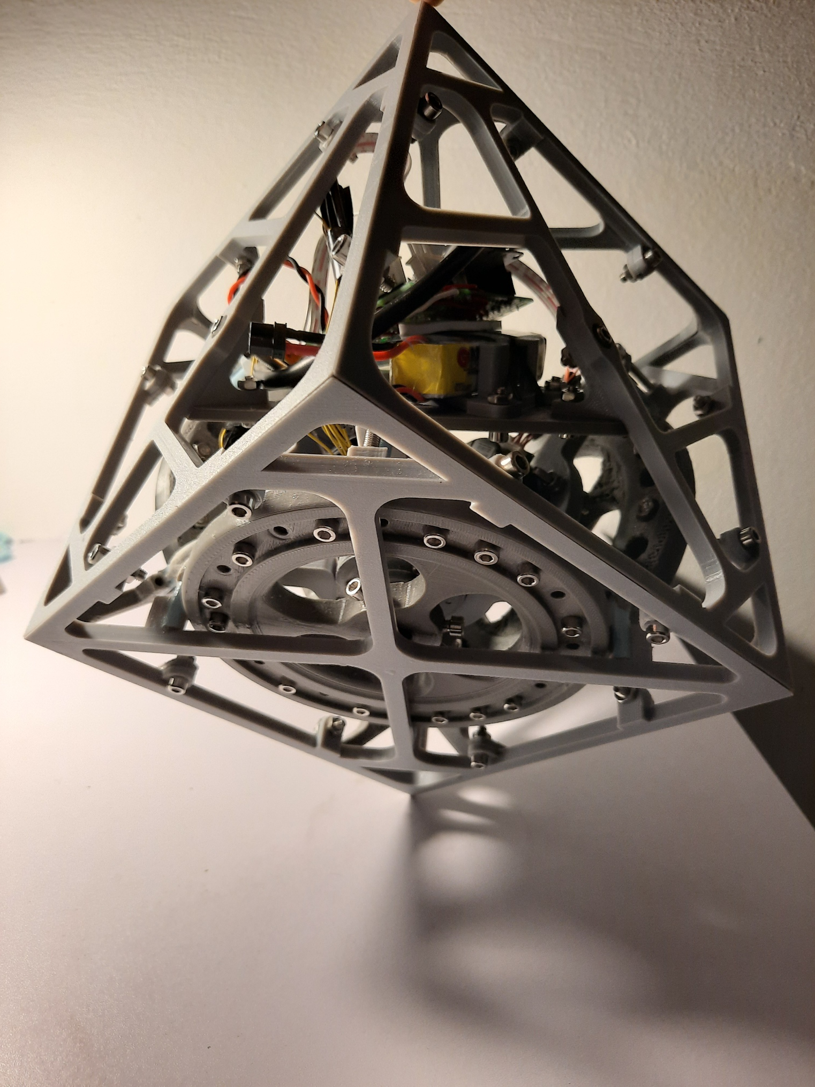
model/20221121_040553.jpg
