nht-cyb/balancing-cube-pendulum/model/20221121_040634.jpg

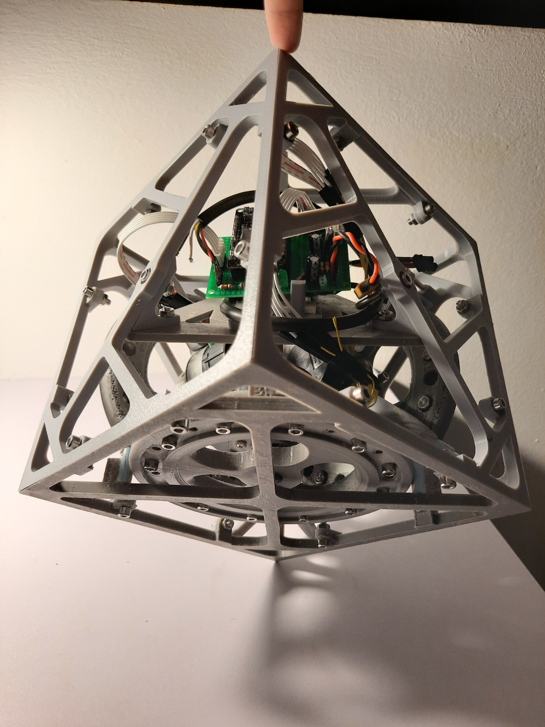
model/20221121_040634.jpg
