nht-cyb/balancing-cube-pendulum/model/20221121_040700.jpg

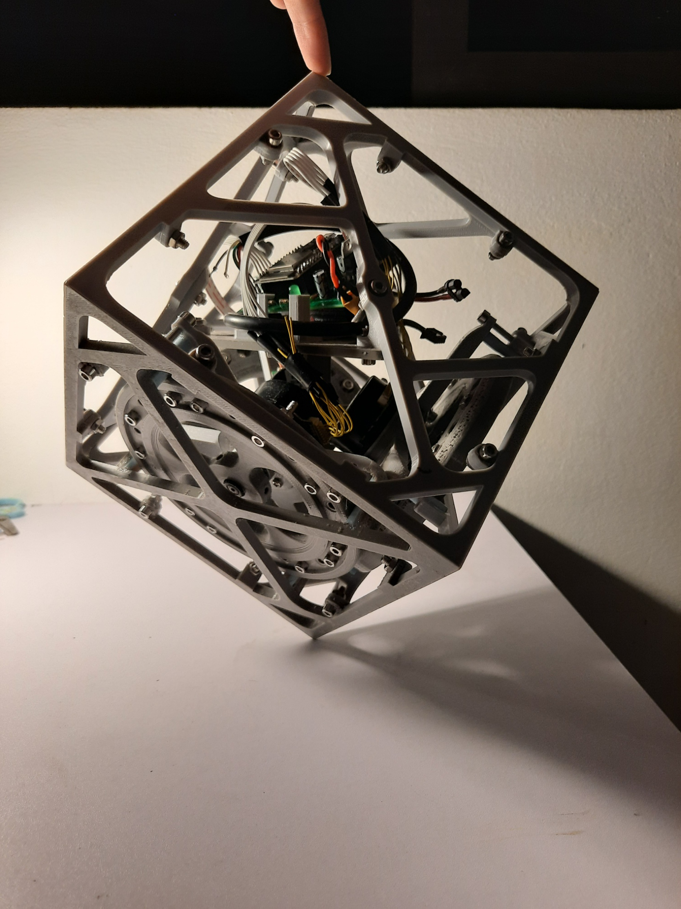
model/20221121_040700.jpg
