nht-cyb/balancing-cube-pendulum/model/20221121_040738.jpg

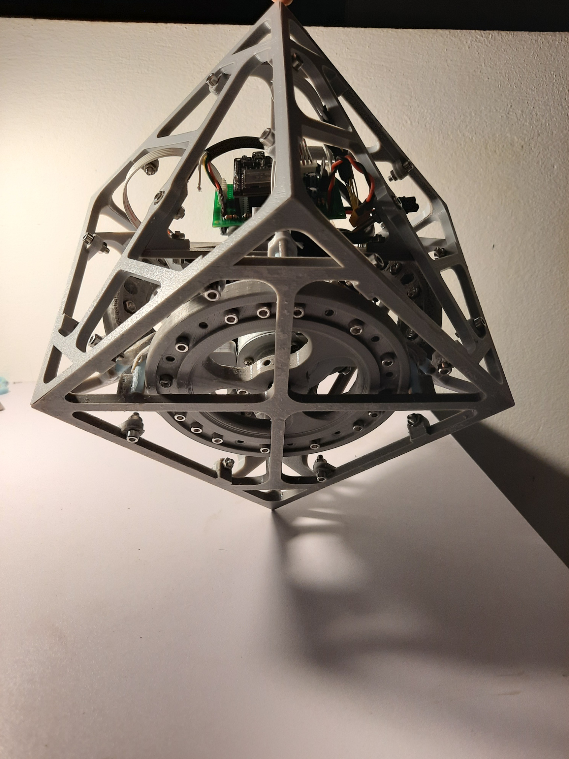
model/20221121_040738.jpg
