nht-cyb/balancing-cube-pendulum/model/NCJ-24H-24-01_BASIC_01.jpg

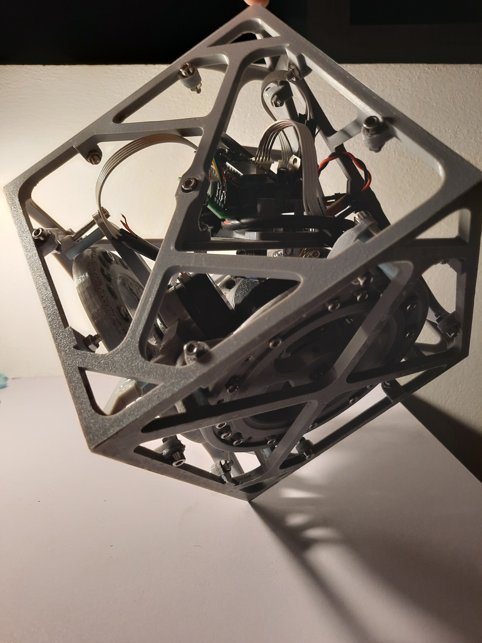
model/NCJ-24H-24-01_BASIC_01.jpg
