nht-cyb/balancing-cube-pendulum/(commit log)

2026-10-06 Add controller code, reports and model photos
    [VTCB.xlsx]
2026-10-06 Rewrite README with setup guide, balancing-point data and demo GIFs; fix controller sketches
    - README: folder guide, how to run, Bluetooth commands, VTCB.xlsx data, GIFs, link to demo videos
    - sketch_nov26a: re-enable motor outputs, fix ID1 '=-' typo, set calibrated after save, keep default offsets when EEPROM is empty
    - sketch_nov21a: correct MPU6050 GYRO_CONFIG and PWR_MGMT_1 register addresses
    [sketch_nov21a_all.ino, sketch_nov26a_all_gotbp_runpcd.ino]
